JamesQFreeman/Bloody_pressure_monitor/analog circuit/README.md

# analog circuit design

We used the MPX5050GP model pressure sensor. The pressure signal from the pressure sensor can be directly used as the current blood pressure value. The pulse wave signal obtained from this simulation circuit is used to find the corresponding systolic pressure and diastolic pressure.

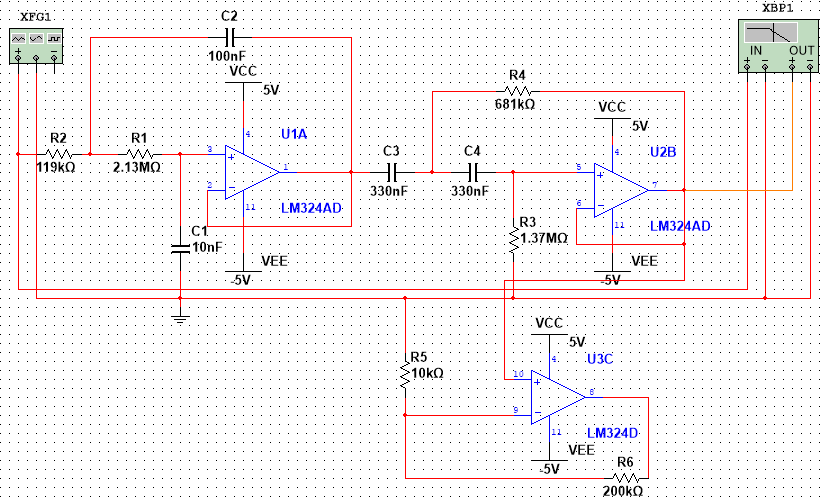
[picture p8: analog circuit/images/电路.png]
电路

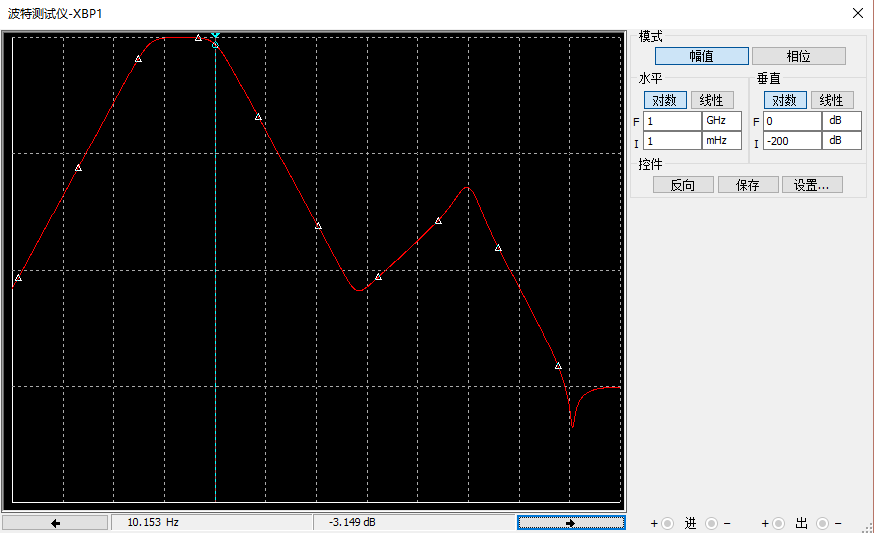
[picture p9: analog circuit/images/低通截止频率.png]
低通截止频率

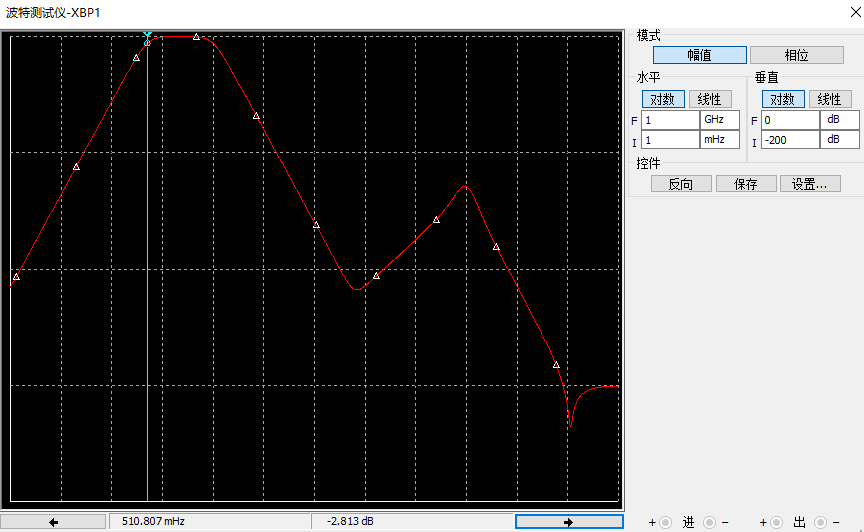
[picture p10: analog circuit/images/高通截止频率.png]
高通截止频率
