JamesQFreeman/Bloody_pressure_monitor/images/微信图片_20180629163834.png

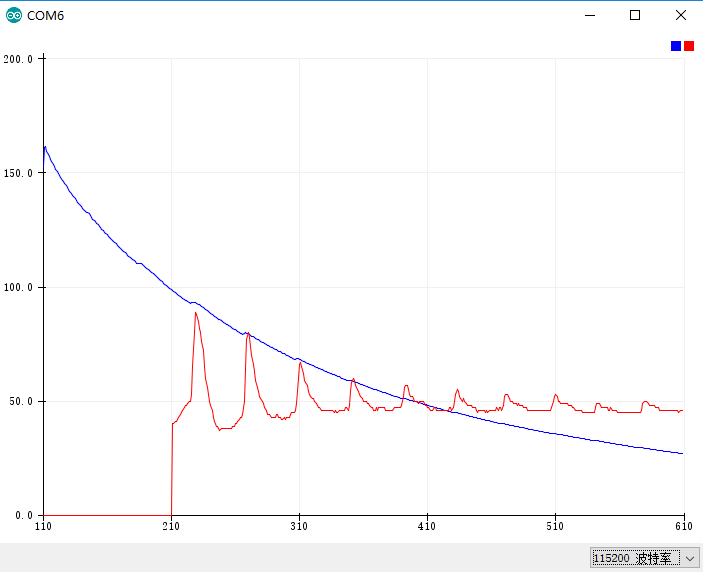
images/微信图片_20180629163834.png
