JamesQFreeman/Bloody_pressure_monitor/images/微信图片_20180629170322.png

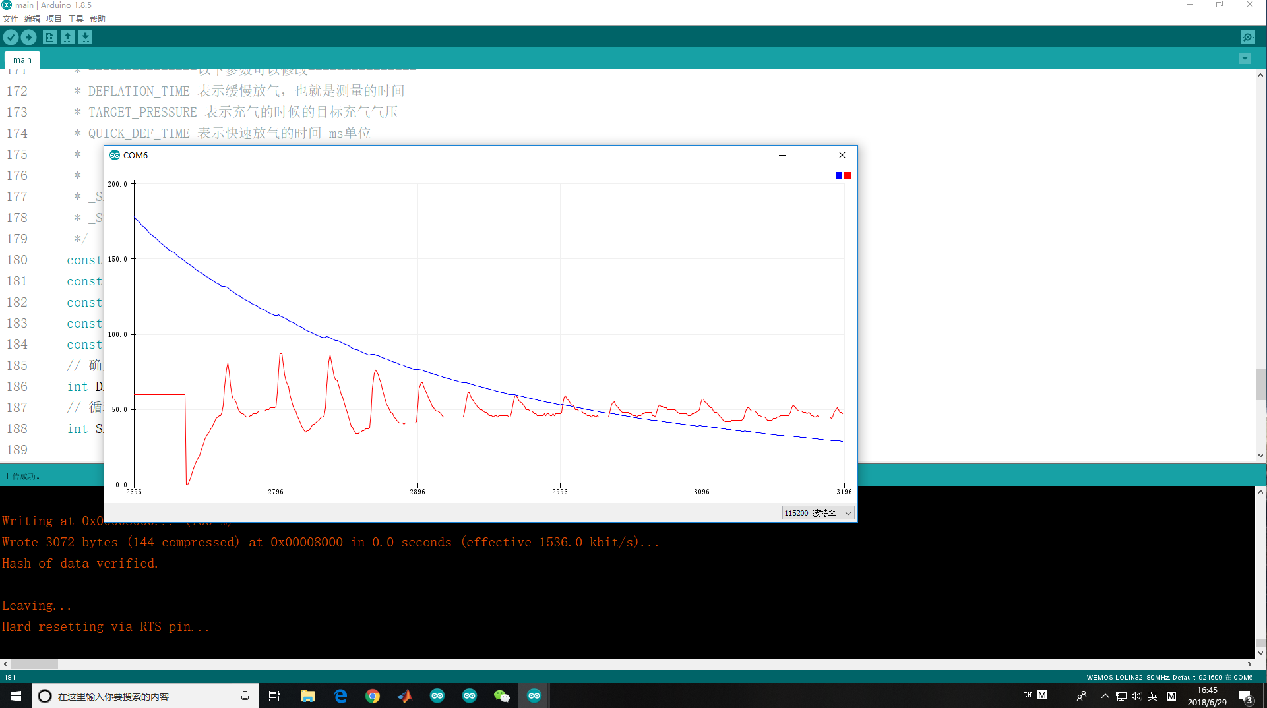
images/微信图片_20180629170322.png
