JamesQFreeman/Bloody_pressure_monitor/(list of files, drawings)

Other design files:
analog circuit/Pulse wave filter amplifier circuit _0.5Hz—10Hz second-order Butterworth bandpass filter.ms12
