JamesQFreeman/Bloody_pressure_monitor/(commit log)

2018-06-29 第一次提交。
    没有出现前几天的疯狂Stack overflow然后一直rebooting的现象。还没有进行测试
2018-06-29 Create README.md
    先开个文件，后续让左来写
2018-06-29 第二次pull
2018-06-29 完美曲线更新
    1. 设计了全新的显示函数，能非常优雅的显示血压。
    2. 对于openM1_closeM2()这种面向底层的函数做了封装和抽象，抽象成为充气和放气函数
    3. 改进了一些缩进问题
    [main.ino]
2018-06-29 readme草稿
    还在写，做个备份，滚去举铁了
2018-06-29 6/29最后一次上传
2018-06-29 OLED屏幕更新0.1
    加入了几个不知道在干嘛的函数居然还能用！
2018-06-29 OLED显示0.2beta
    这个版本可以跑了！
    但是明显感觉OLED_display函数消耗了大量的时间。
2018-06-30 冒力的readmeen
2018-06-30 成的第一次尝试
2018-06-30 6/30第一次发布
    修改了一些图片，去掉了隐私信息
    增加一些照片
    修改了readme的时钟信号处理和遇到的问题
2018-06-30 模拟电路仿真文件
    [Pulse wave filter amplifier circuit _0.5Hz—5Hz second-order Butterworth bandpass filter.ms12]
2018-06-30 readme修改
    添加了一个硬件组成表格
2018-06-30 表格修改
2018-06-30 改进了超慢的OLED显示，添加了平均压的测量，优化了性能。
2018-06-30 Revert "6.30第一次小修改"
    This reverts commit a44d28641a66b41e8e98a50c315ce584c4f9a084, reversing
    changes made to c8cbfd7d7d865a6d1cdb8adc3a078b186f39cc21.
2018-06-30 Revert "放大滤波"
    This reverts commit d51202947dfae9c482e3e9ee1b2a0421ef3125aa, reversing
    changes made to a44d28641a66b41e8e98a50c315ce584c4f9a084.
    [Pulse wave filter amplifier circuit _0.5Hz—5Hz second-order Butterworth bandpass filter.ms12]
2018-06-30 修了Stackoverflow rebooting的bug
    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
    [main.ino]
2018-06-30 刚才好像滚崩了 重新来一次
2018-06-30 Revert "模拟电路仿真"
2018-06-30 没事 问题不大 不慌
    [Pulse wave filter amplifier circuit _0.5Hz—5Hz second-order Butterworth bandpass filter.ms12]
2018-06-30 在加网络模块前的最后一次提交
2018-07-01 WIFI更新
    wifi功能可用啦
2018-07-02 WIFI 0.3可用版本
    解决了傻逼编译器带来的多线程bug。
2018-07-02 WIFI更新1.0
    去掉了下面的图。完成了收缩压和舒张压的显示
    可非常正常的工作
2018-07-02 deleted the html
    [database.csv]
2018-07-03 远程示波功能可以用了
    服务器端的程序还没有上传
2018-07-04 this code could run smoothly (maybe
    [database.csv]
